plskeggs/nubotics-wheelwatcher/code/examples/oopic/oopic_bot.jpg

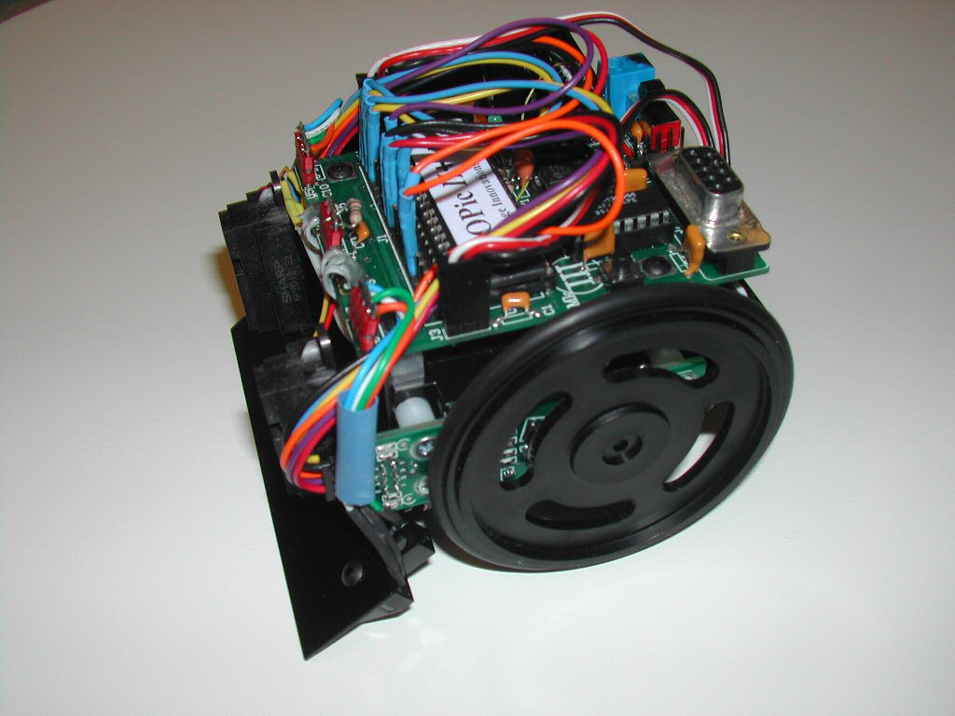
code/examples/oopic/oopic_bot.jpg
