plskeggs/nubotics-wheelwatcher/README.md

# nubotics-wheelwatcher
Welcome to the open hardware and firmware repository for the Nubotics WheelWatcher encoders, 
models WW-11 (for standard size servos) and WW-12 (for specific gearhead motors).

We started designing and manufacturing the original WheelWatcher encoders in 2004.
Much has changed in the hobby robotics field in the last 12 years.  We ceased
manufacturing both products, and closed our web store after selling the last
WheelWatchers, in late 2015.

Rather than letting these designs disappear into the ether, we are opening them up so that
others may carry the torch and either build them for themselves or manufacturer
and sell them to others.  We only ask that you read, understand, and respect
the licenses we have applied.

The hardware portions are licensed under The TAPR Open Hardware License
Version 1.0 (May 25, 2007).  See the file hardware/LICENSE.TXT or find it here:
http://www.tapr.org/OHL.

The firmware portions are licensed under the Gnu Public License (GPL) v3
(June 29, 2007).  See the file code/WW-1x-firmware/COPYING or find it here:
http://www.gnu.org/licenses/.

The example programs are provided as-is, public domain.

January 2016, Noetic Design, Inc.
