plskeggs/nubotics-wheelwatcher/hardware/AL-02/tooling-c.pdf

Date 2/8/2005 | Document Number | Sheet 1 1 002-0005-001
1.04 | | Of

# WheelWatcher Alignment Tool

## Noetic Design, Inc. 25 NW 23rd PL STE 6 PMB 181

## Portland, OR 97210

503-223-9239

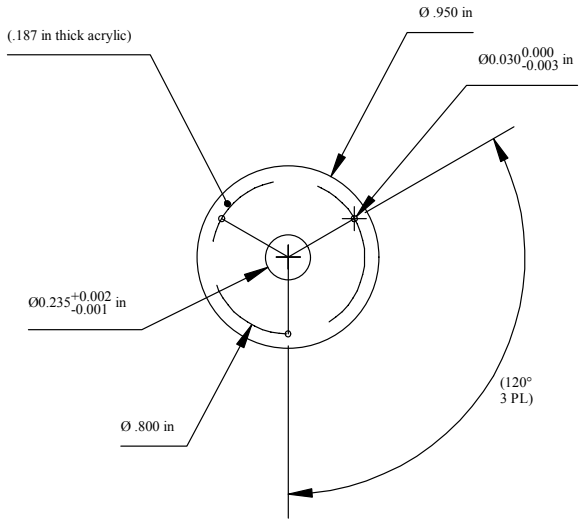
[picture p2: figure]
(.187 in thick acrylic)
