plskeggs/nubotics-wheelwatcher/hardware/WW-11/mechanical/detector-spacing.pdf

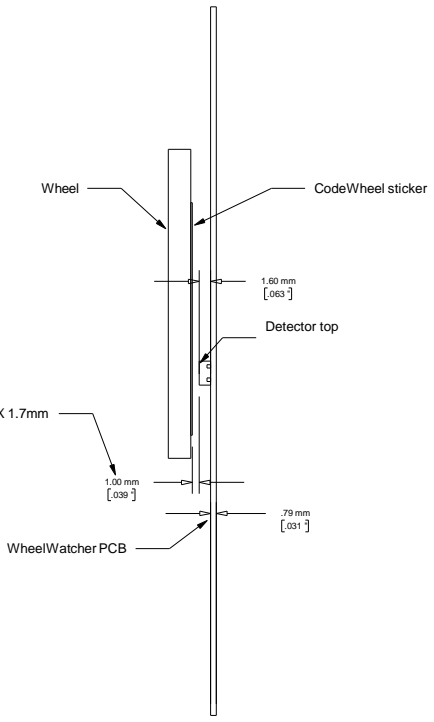
[picture p3: figure]
CodeWheel sticker; WheelWatcher PCB; Detector top; Wheel

Detector to CodeWheel spacing: MIN 0.3mm, MAX 1.7mm
