plskeggs/nubotics-wheelwatcher/hardware/WW-11/mechanical/detector-spacing.png

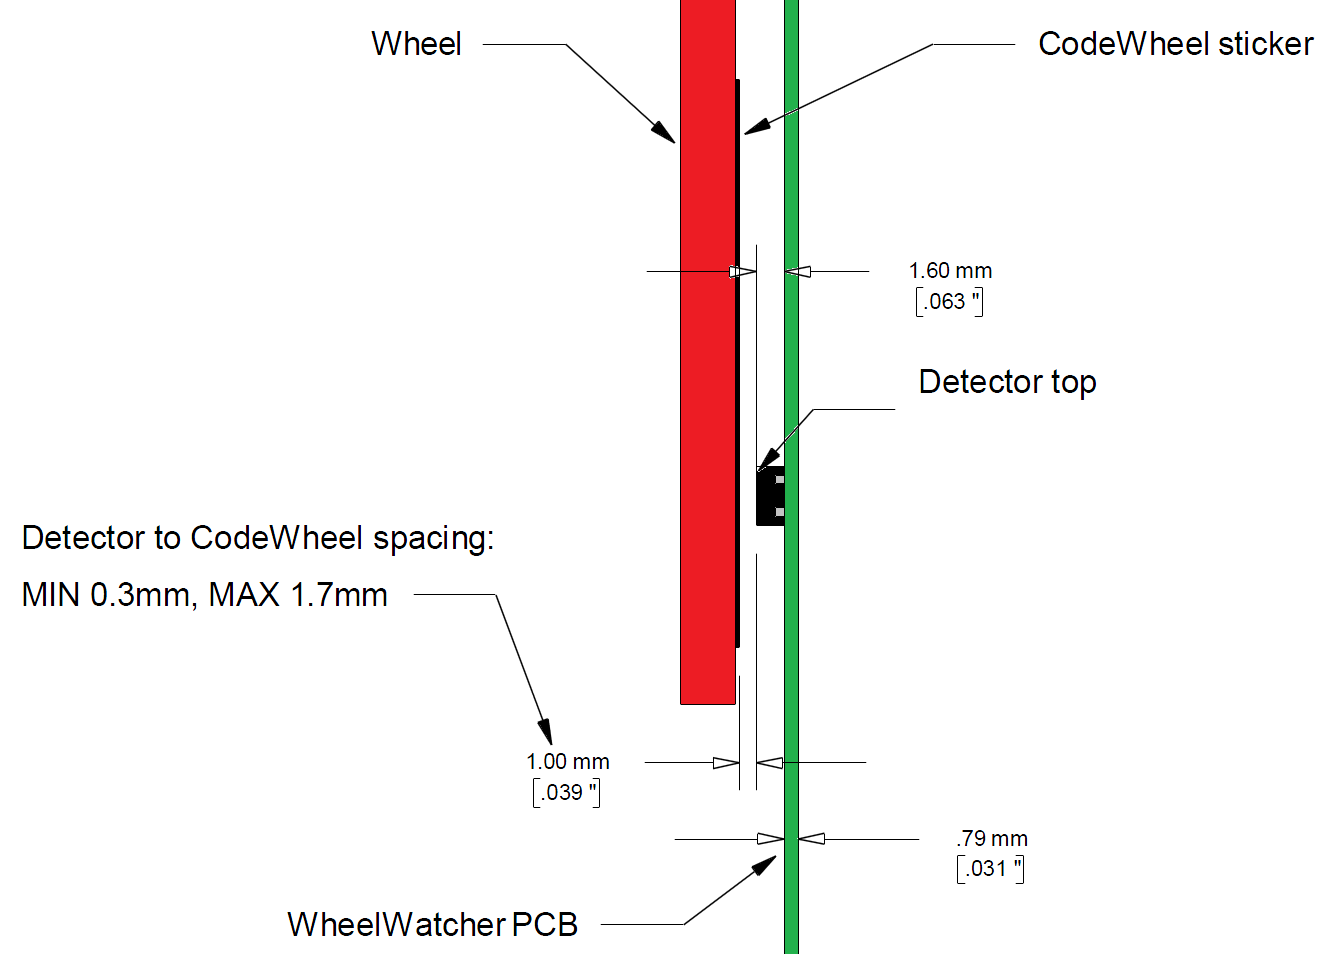
hardware/WW-11/mechanical/detector-spacing.png
