plskeggs/nubotics-wheelwatcher/hardware/WW-11/mechanical/fab.png

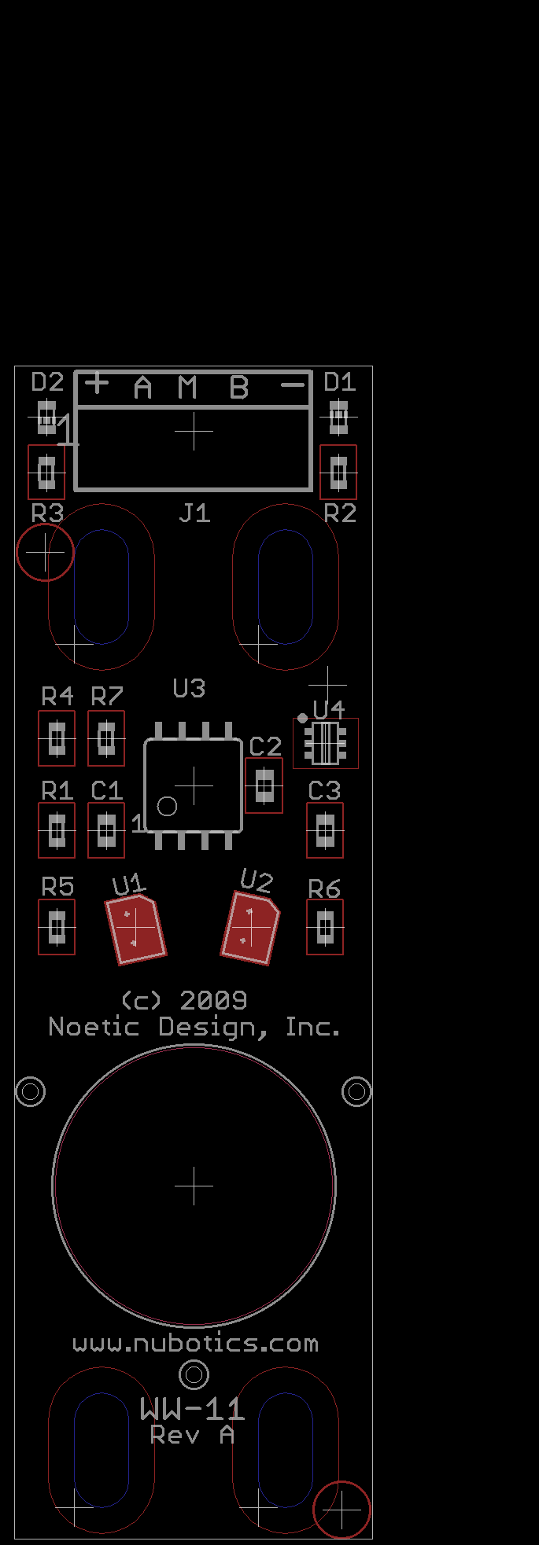
hardware/WW-11/mechanical/fab.png
