plskeggs/nubotics-wheelwatcher/hardware/WW-11/mechanical/WW-11-outline.png

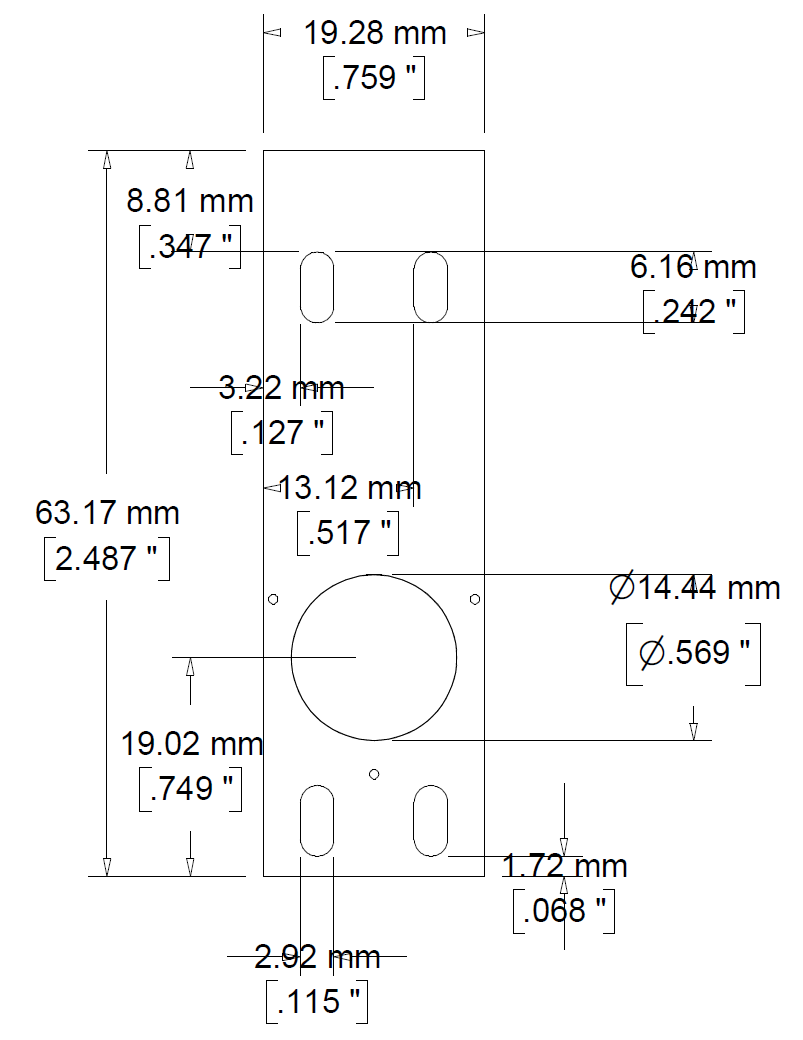
hardware/WW-11/mechanical/WW-11-outline.png
