plskeggs/nubotics-wheelwatcher/hardware/WW-12/mechanical/WW-12-outline.png

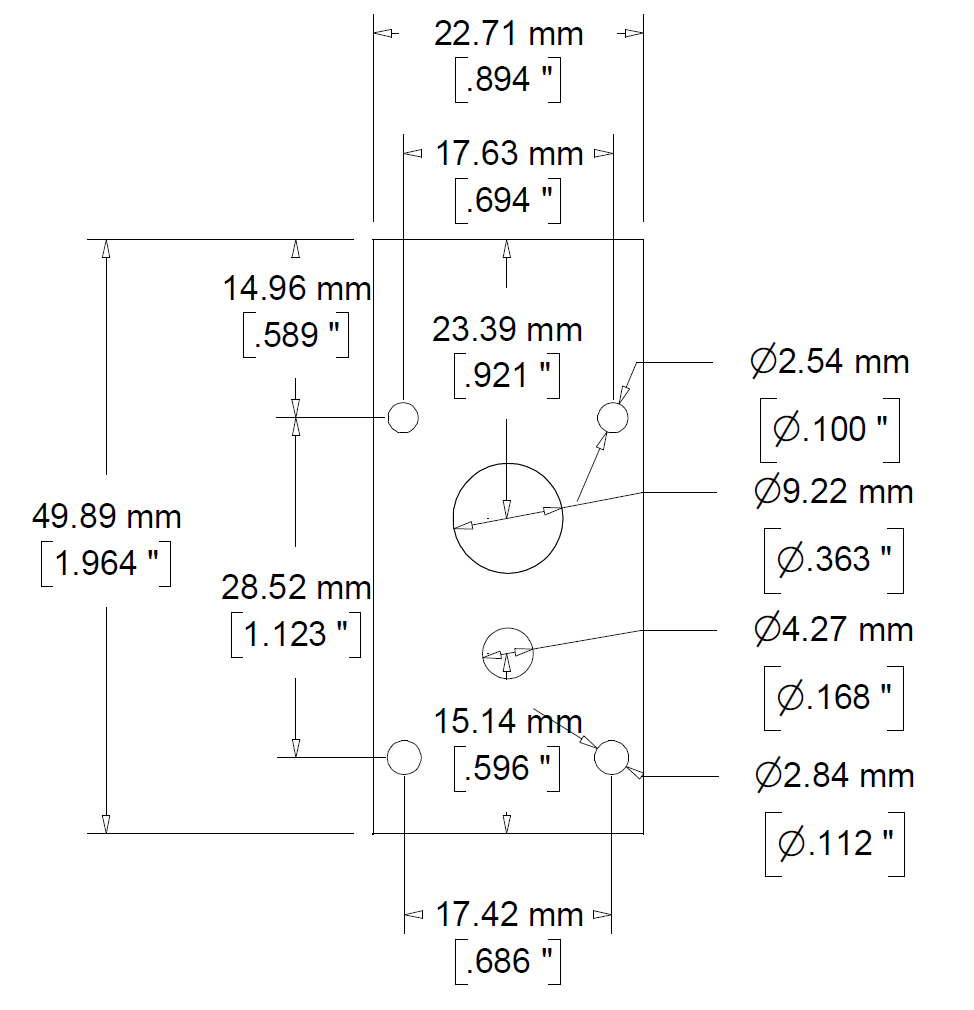
hardware/WW-12/mechanical/WW-12-outline.png
