plskeggs/nubotics-wheelwatcher/hardware/WW-11/WW-11-BOM.xls

 |  |  | Wheel Watcher Encoder WW-11
 |  |  | Rev A
 |  |  | Noetic Design, Inc.
 |  |  | 25 NW 23rd PL STE 6 PMB 181
 |  |  | Portland, Oregon 97210
 |  |  | 503-223-9239
 |  |  | Bill Of Materials |  |  |  |  |  |  |  |  |  |  | 500 | 1000
 |  |  |  |  |  |  |  |  |  |  |  |  | -1000 | Cost | Cost | delta
Item | Qty | Ord | Part Description | Case | Manufacturer | Part Number | Ref Designator | Mouser | Digikey | Price Each |  | Total
1 | 3 |  | Capacitor, Ceramic, 16V, X7R, 100 nF | 0603 |  |  | C1, C2, C3 |  |  | $0.01 | 3 | $0.01 | $0.01 | $7.50 | $15.00 | $7.50
2 | 1 |  | Diode, Light Emitting, Yellow, SMT | 0603 | Liteon | LTST-C190KYKT | D1 |  | 67-1551-1-ND | $0.06 | 1 | $0.06 | $0.06 | $27.50 | $55.00 | $27.50
3 | 1 |  | Diode, Light Emitting, Green, SMT | 0603 | Liteon | LTST-C190KGKT | D2 |  | 67-1693-1-ND | $0.06 | 1 | $0.06 | $0.06 | $27.50 | $55.00 | $27.50
4 | 1 |  | Resistor, Thick Film 0.1W, 50V, 1%, 100 ohm | 603 |  |  | R1 |  |  |  | 1
5 | 2 |  | Resistor, Thick Film, 0.1W, 50V, 1%, 475 ohm | 0603 |  |  | R2, R3 |  |  | $0.002 | 2 | $0.004 | $0.004 | $2.00 | $4.00 | $2.00
6 | 1 |  | Resistor, Thick Film, 0.1W, 50V, 1%, 1.0 M | 0603 |  |  | R4 |  |  | $0.002 | 1 | $0.002 | $0.002 | $1.00 | $2.00 | $1.00
7 | 2 |  | Resistor, Thick Film, 0.1W, 50V, 1%, 40.0K | 0603 |  |  | R5, R6 |  |  | $0.002 | 2 | $0.004 | $0.004 | $2.00 | $4.00 | $2.00
8 | 0 |  | Resistor, Thick Film, 0.1W, 50V, 1%, 0 ohm | 0603 |  |  | R7 |  |  | $0.002 | 0 | $0.00 | $0.00 | $0.00 | $0.00 | $0.00
9 | 2 |  | Photomicrosensor, SMT | 4TSOP | Fairchild | QRE1113GR | U1, U2 |  |  | $0.48 | 2 | $0.96 | $0.96 | $480.00 | $960.00 |  | tape/reel? Get quote for 2000-3000
10 | 1 |  | Atmel ATTINY85 Microcontroller, 8K Flash | SOIC8 | Atmel | ATtiny85-15ST | U3 |  |  |  | 1
11 | 1 |  | Dual Schmidt Trigger Inverter, SMT | SC70-6 | Fairchild | NC7WZ14P6X | U4 | 512-NC7WZ14P6X |  | $0.09 | 1 | $0.09 | $0.09 | $45.00 | $810.00 | $765.00 | $0.77 | 750% | 3000 units in tape and reel for 0.27 each = | 810
 |  |  | PCB component total |  |  |  |  |  |  |  |  | $1.19 | $1.19
15 | 1 |  | PCB fab |  |  |  |  | (2 week, Advanced Circuits) |  | $2.86 |  | $2.86 | $0.00 | $1430.00 | $0.00
16 | 1 |  | PCB assy |  |  |  |  | (CBRAM) |  | $2.50 |  | $2.50 | $2.00 | $1250.00 | $2000.00
 |  |  | assembled PCB total |  |  |  |  |  |  |  |  | $6.54 | $3.19
17 | 1 |  | encoder disk |  |  |  |  | (Gillespie, I-Cut) |  | $0.94 |  | $0.94 | $0.66 | $470.00 | $660.00 | $190.00
18 | 0 |  | alignment tool |  |  |  |  | (Filener laser cut + 3 .031" pins) |  | $0.77 |  | $0.00 | $0.00 | $0.00 | $0.00
19 | 1 |  | hardware (screws, standoffs) |  |  |  |  |  |  | $0.68 |  | $0.68 | $0.68 | $340.00 | $680.00
 |  |  | total |  |  |  |  |  |  |  |  | $8.16 | $4.53
 | 1 |  | alt- PKC connector |  |  |  |  |  |  |  |  | $1.15 | $1.08
20 | 1 |  | right angle header | 1 | Hirose | DF11-8DP-2DS(22) | J1 |  | H2063-ND | $0.20 |  | $0.20 | $0.20
20 | 0 |  | connector housing | 1 | Hirose | DF11-8DS-2C |  |  | H2022-ND | $0.07 |  | $0.00 | $0.00 | $0.00 | $0.00 | $0.00
21 | 0 | Ö | wires, 6 different colors | 6 | Digikey | H3BXT-10106-B6-ND |  |  | H3BXT-10106-B6-ND | $0.32 |  | $0.00 | $0.00 | $0.00 | $0.00 | $0.00
 |  |  | complete kit |  |  |  |  |  |  |  |  | $9.51 | $5.81
 |  |  |  |  |  |  |  |  |  |  |  | $8.16 | $5.25 | $4082.50 | $5245.00 | $1022.50
 |  |  |  | MSRP | 500 | 1000
 |  |  | with Digikey cabling |  | 29.39 | 23.2
 |  |  | with PKC cabling |  | 26.8 | 21.29
 |  |  | reduction (order 1000, use PKC): |  |  | 0.2756039469
