plskeggs/nubotics-wheelwatcher/hardware/WW-12/WW-12-BOM.xls

Sheet: bom
WW-12 Rev A BOM
Part | Quantity | Part Number | Value | Package | Delivered to SMTNW | 2012-11-01
C1-C3 | 3 | 11-0165 | 0.1uF | C0603 | 2500
D1 | 1 | 04-0232 | LTST-C190KYKT yellow | CHIP-LED0603 | 3000
D2 | 1 | 04-0128 | LTST-C190KGKT green | CHIP-LED0603 | 3000
J1 | 1 | 13-0262 | 22-23-2051 | 22-23-2051 | 420 | NOTE: these are the hand-adds, and we're short. Please just do the 420 and we'll do the last 100 when they come in.
R1 | 1 | 10-0131 | 100 | R0603 | 3500
R2-R3 | 2 | 10-0124 | 470 | R0603 | 4000
R4 | 1 | 10-0263 | 1M | R0603 | 4000
R5-R6 | 2 | 10-0264 | 40K | R0603 | 3000
R7 | 1 | 10-0194 | 0 | R0603 | 4000
U1-U2 | 2 | 03-0261 | QRE1113GR | 4TSOP | 1052 | NOTE: this is barely enough. If you run out, omit from the rest of the run.
U3 | 1 | 00-0260 | Atmel ATTINY85 | SOIC8 | 535
U4 | 1 | 02-0127 | NC7WZ14P6X | SOT65P210X110-6AN_SC88_SC70-6 | 1500
PCB | 1 | 17-0273 | 2 sided 0.031" FR4 |  | 0 | NOTE: due to arrive Monday 11/5/2012 from Advanced Circuits.

Sheet: parts
WW-12 Rev A BOM
Part | Part Number | Value | Package | Position (inch) | Orientation | Quantity
C1 | 11-0165 | 0.1uF | C0603 | (0.205 1.465) | R270 | 4000
C2 | 11-0165 | 0.1uF | C0603 | (0.645 0.8) | R270
C3 | 11-0165 | 0.1uF | C0603 | (0.555 1.465) | R270
D1 | 04-0232 | LTST-C190KYKT yellow | CHIP-LED0603 | (0.72 1.96) | R90 | ~1000
D2 | 04-0128 | LTST-C190KGKT green | CHIP-LED0603 | (0.04 1.96) | R270 | ~1000
J1 | 13-0262 | 22-23-2051 | 22-23-2051 | (0.38 1.845) | R0 | 0 (backordered)
R1 | 10-0131 | 100 | R0603 | (0.115 0.8) | R90 | ~4000
R2 | 10-0124 | 470 | R0603 | (0.72 1.845) | R180 | 5000
R3 | 10-0124 | 470 | R0603 | (0.04 1.845) | R0
R4 | 10-0263 | 1M | R0603 | (0.205 1.605) | R270 | ~4500
R5 | 10-0264 | 40K | R0603 | (0.545 0.8) | R90 | ~4000
R6 | 10-0264 | 40K | R0603 | (0.215 0.8) | R90
R7 | 10-0194 | 0 | R0603 | (0.555 1.605) | R90 | ~4500
U1 | 03-0261 | QRE1113GR | 4TSOP | (0.582 0.608) | R21.1 | 1025
U2 | 03-0261 | QRE1113GR | 4TSOP | (0.178 0.608) | R338.9
U3 | 00-0260 | Atmel ATTINY85 | SOIC8 | (0.38 1.535) | R0 | 510
U4 | 02-0127 | NC7WZ14P6X | SOT65P210X110-6AN_SC88_SC70-6 | (0.715 1.635) | R0 | ~2000
PCB | 17-0273 | 2 sided 0.031" FR4
