plskeggs/nubotics-wheelwatcher/hardware/WW-11/mechanical/WW-11.dxf

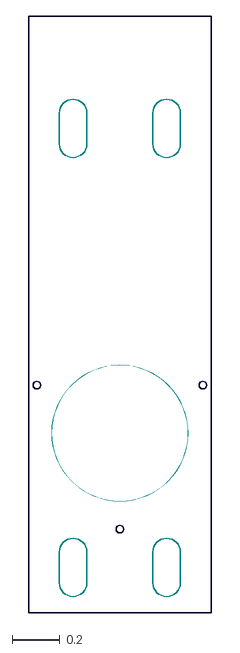
[picture p8: CAD file, 2016-01-25]
hardware/WW-11/mechanical/WW-11.dxf
0.759 x 2.49
