plskeggs/nubotics-wheelwatcher/hardware/WW-12/mechanical/WW-12.dxf

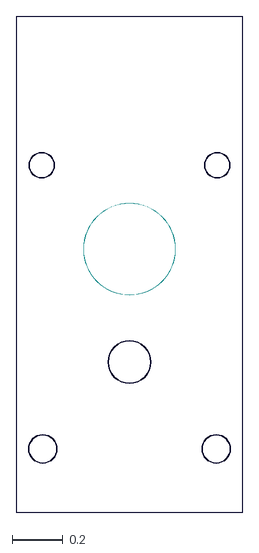
[picture p9: CAD file, 2016-01-25]
hardware/WW-12/mechanical/WW-12.dxf
0.895 x 1.97
