plskeggs/nubotics-wheelwatcher/(list of files, cad)

Other CAD files:
hardware/WW-11/test fixture/test-fixture2.dwg
