plskeggs/nubotics-wheelwatcher/hardware/WW-11/WW-11-layout.pdf

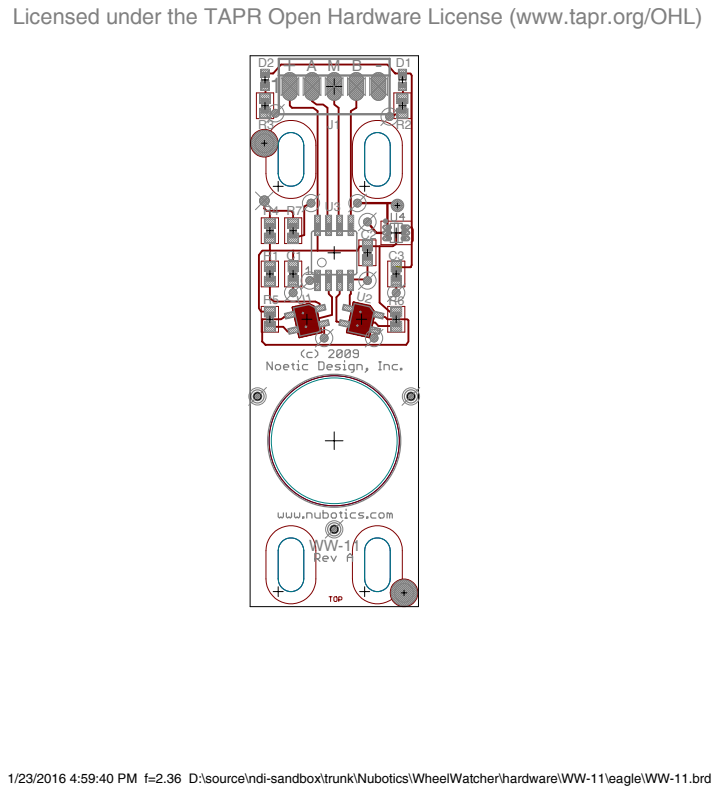
[picture p23: page 1]

Licensed under the TAPR Open Hardware License (www.tapr.org/OHL)

1/23/2016 4:59:40 PM f=2.36 D:\source\ndi-sandbox\trunk\Nubotics\WheelWatcher\hardware\WW-11\eagle\WW-11.brd
