plskeggs/nubotics-wheelwatcher/hardware/WW-11/WW-11-schematic.pdf

A

A

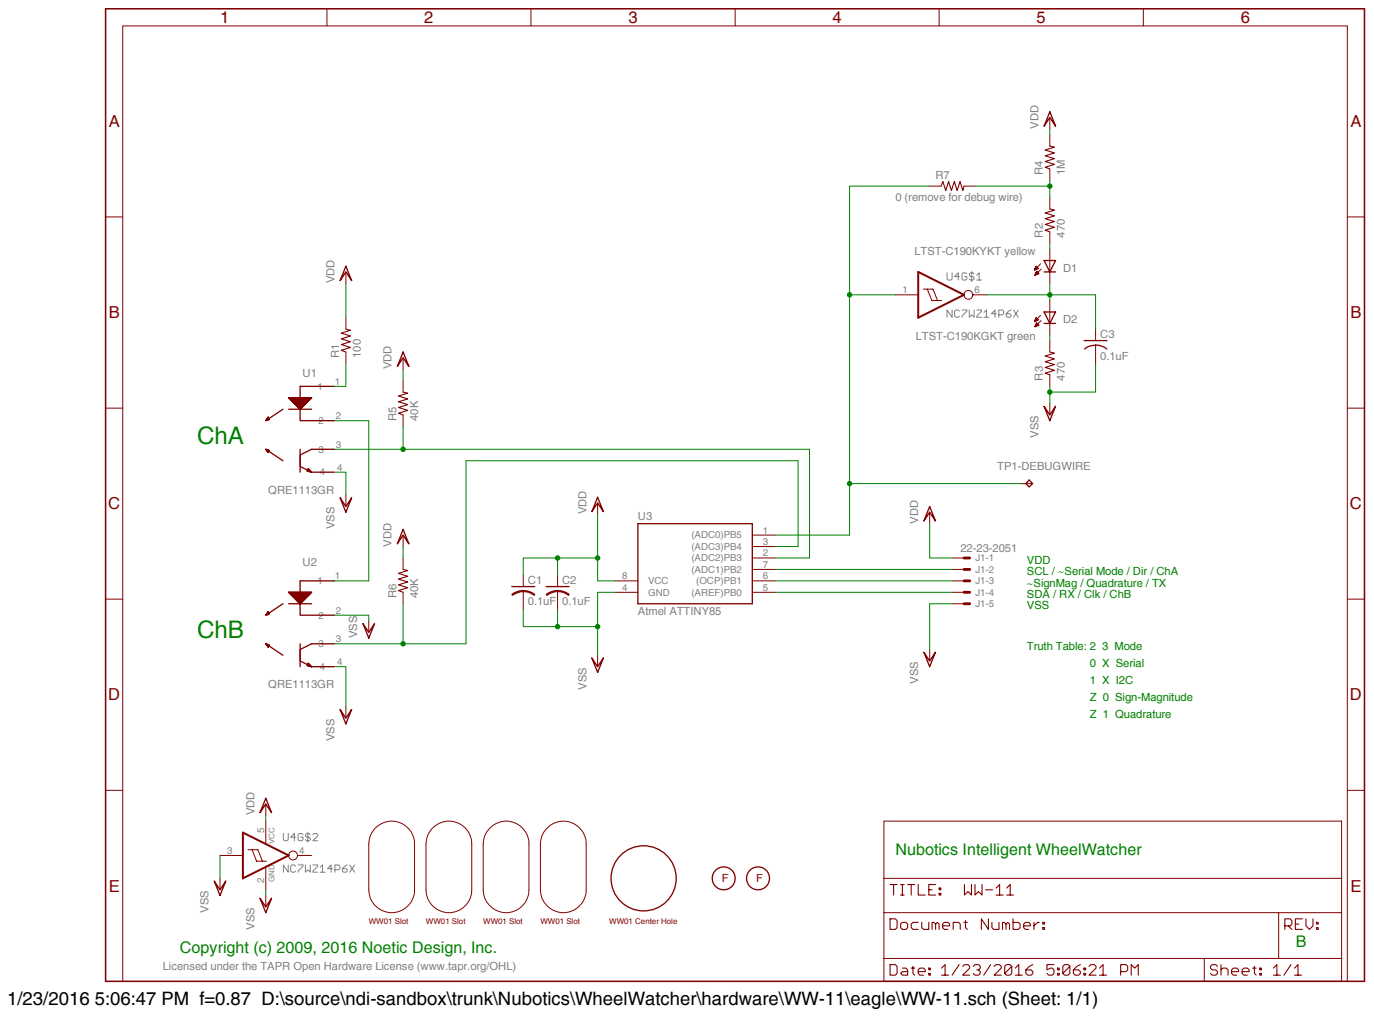
[picture p24: page 1]

0 (remove for debug wire)

VDD
SCL / ~Serial Mode / Dir / ChA
~SignMag / Quadrature / TX
SDA / RX / Clk / ChB
VSS

Copyright (c) 2009, 2016 Noetic Design, Inc.
Licensed under the TAPR Open Hardware License (www.tapr.org/OHL)

1/23/2016 5:06:47 PM f=0.87 D:\source\ndi-sandbox\trunk\Nubotics\WheelWatcher\hardware\WW-11\eagle\WW-11.sch (Sheet: 1/1)
