plskeggs/nubotics-wheelwatcher/hardware/WW-12/WW-12-layout.pdf

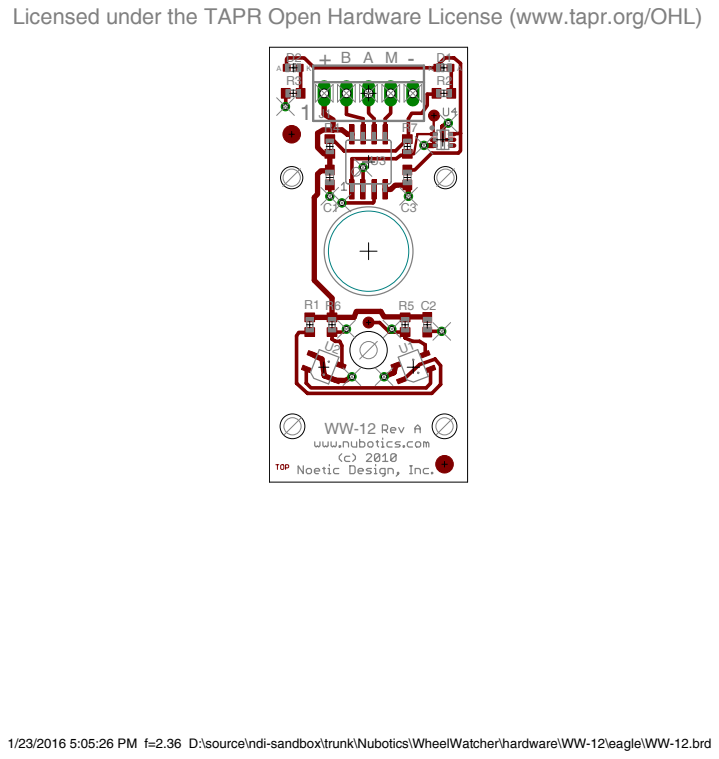
[picture p25: page 1]

Licensed under the TAPR Open Hardware License (www.tapr.org/OHL)

1/23/2016 5:05:26 PM f=2.36 D:\source\ndi-sandbox\trunk\Nubotics\WheelWatcher\hardware\WW-12\eagle\WW-12.brd
