plskeggs/nubotics-wheelwatcher/hardware/WW-12/WW-12-schematic.pdf

A

A

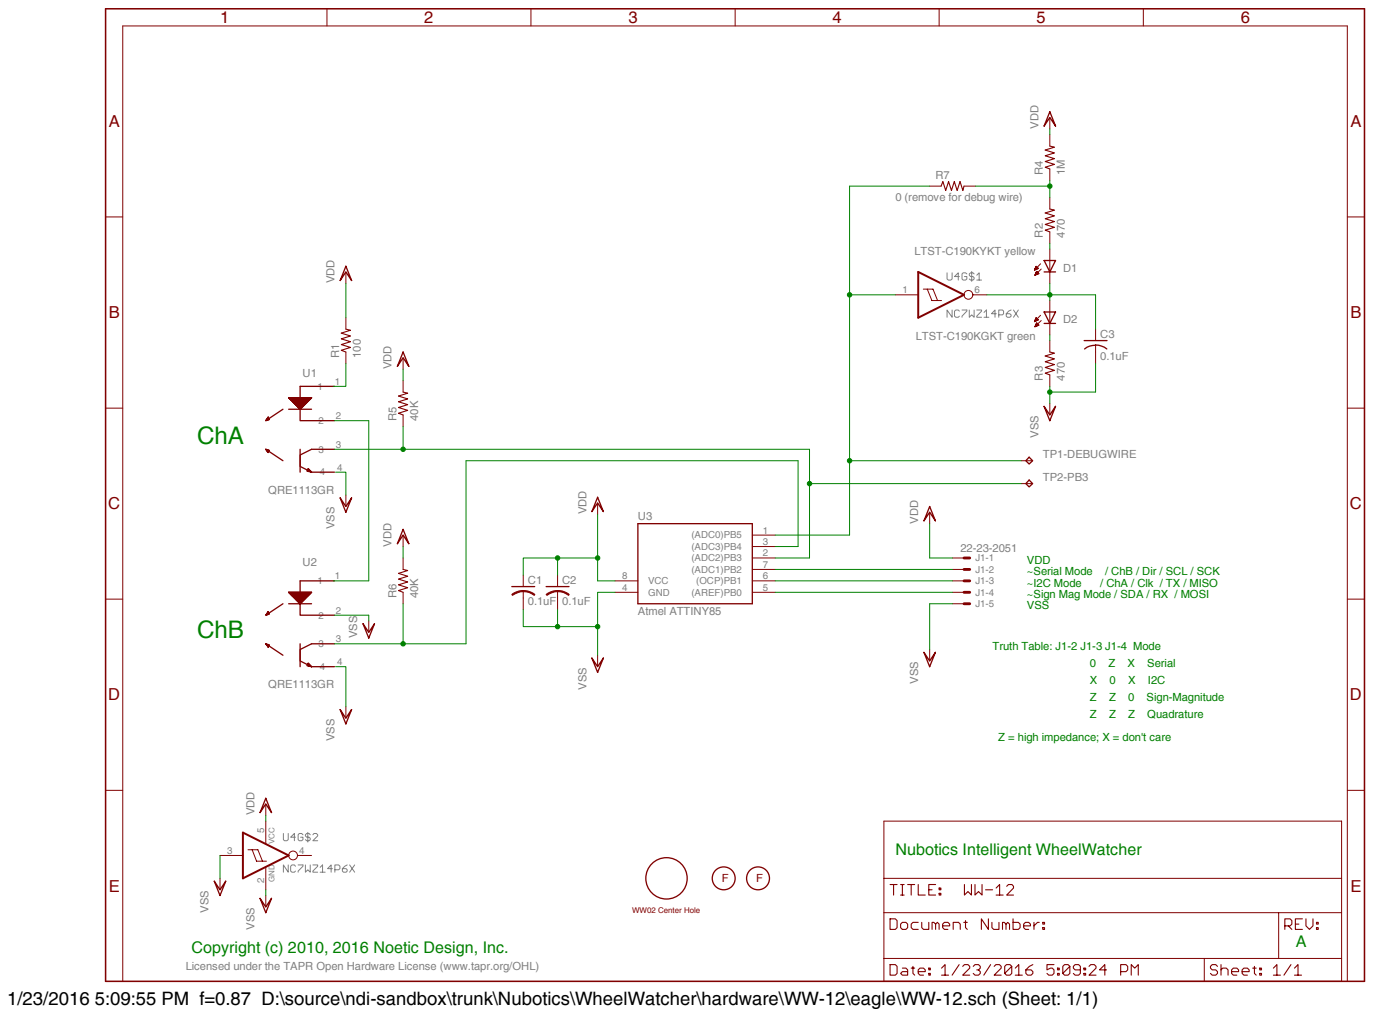
[picture p26: page 1]

0 (remove for debug wire)

VDD
~Serial Mode / ChB / Dir / SCL / SCK
~Sign Mag Mode / SDA / RX / MOSI
VSS

Z = high impedance; X = don't care

Copyright (c) 2010, 2016 Noetic Design, Inc.
Licensed under the TAPR Open Hardware License (www.tapr.org/OHL)

1/23/2016 5:09:55 PM f=0.87 D:\source\ndi-sandbox\trunk\Nubotics\WheelWatcher\hardware\WW-12\eagle\WW-12.sch (Sheet: 1/1)
