plskeggs/nubotics-wheelwatcher/hardware/WW-11/mechanical/ww-11-fab.pdf

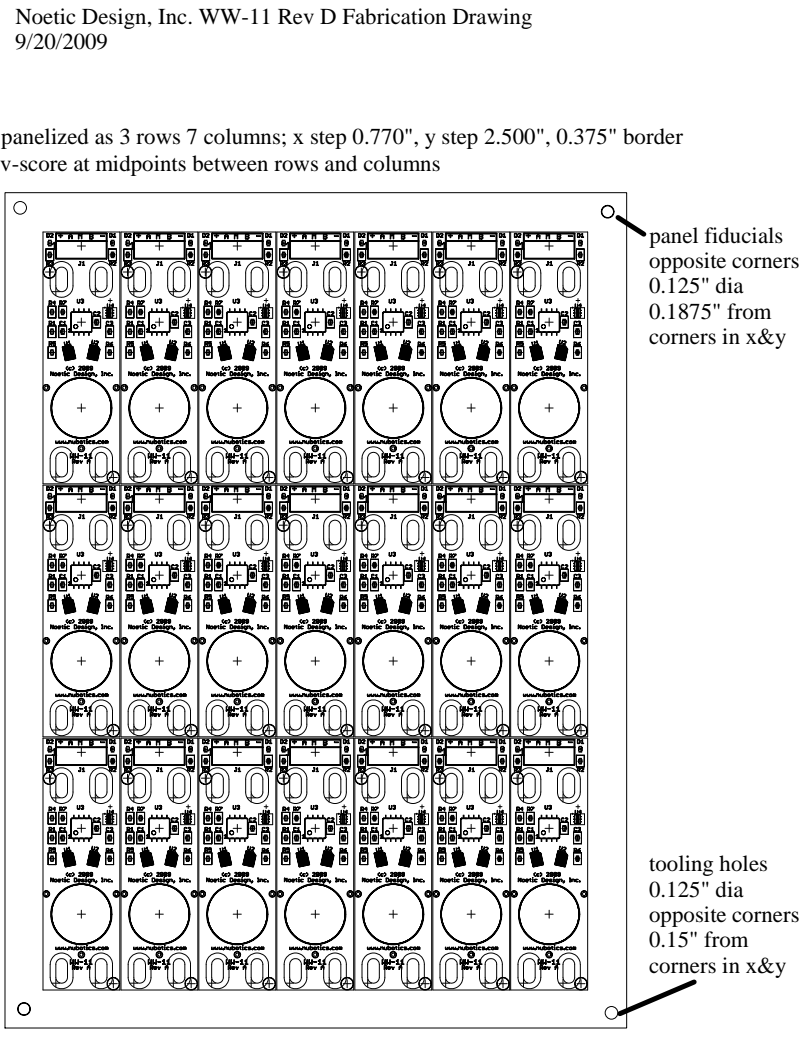
[picture p27: page 1]
panel fiducials opposite corners 0.125" dia 0.1875" from corners in x&y; tooling holes 0.125" dia opposite corners 0.15" from corners in x&y

Noetic Design, Inc. WW-11 Rev D Fabrication Drawing

panelized as 3 rows 7 columns; x step 0.770", y step 2.500", 0.375" border
v-score at midpoints between rows and columns
