plskeggs/nubotics-wheelwatcher/hardware/WW-12/programming fixture/WW-12-fixture-layout.pdf

## Licensed under the TAPR Open Hardware License (www.tapr.org/OHL)

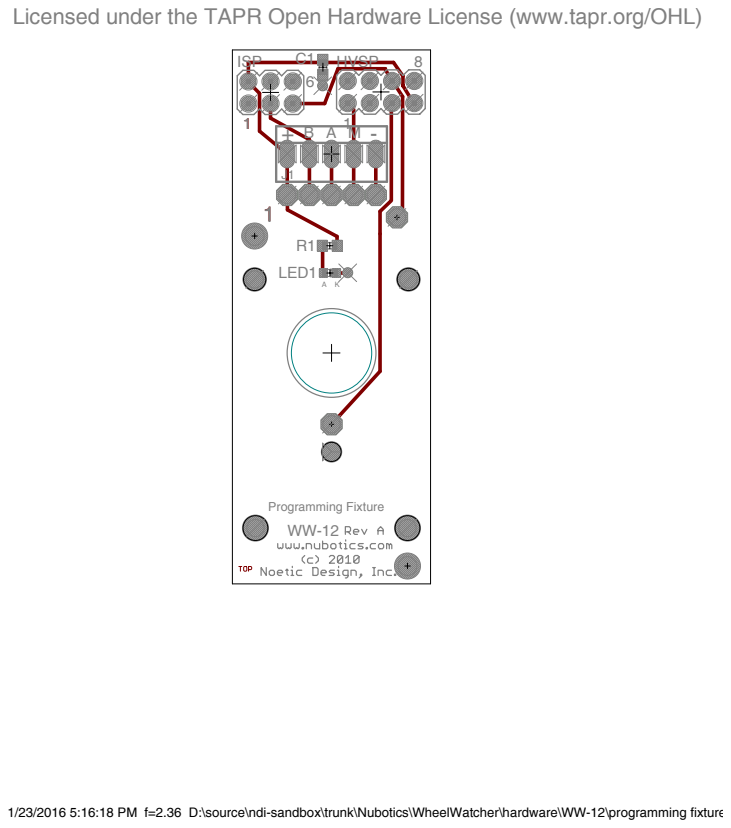
[picture p28: page 1]
Programming Fixture; ISP; HVSP; LED1

1/23/2016 5:16:18 PM f=2.36 D:\source\ndi-sandbox\trunk\Nubotics\WheelWatcher\hardware\WW-12\programming fixture\WW-12-fixture.brd
