plskeggs/nubotics-wheelwatcher/hardware/WW-12/programming fixture/WW-12-fixture-schematic.pdf

A

A

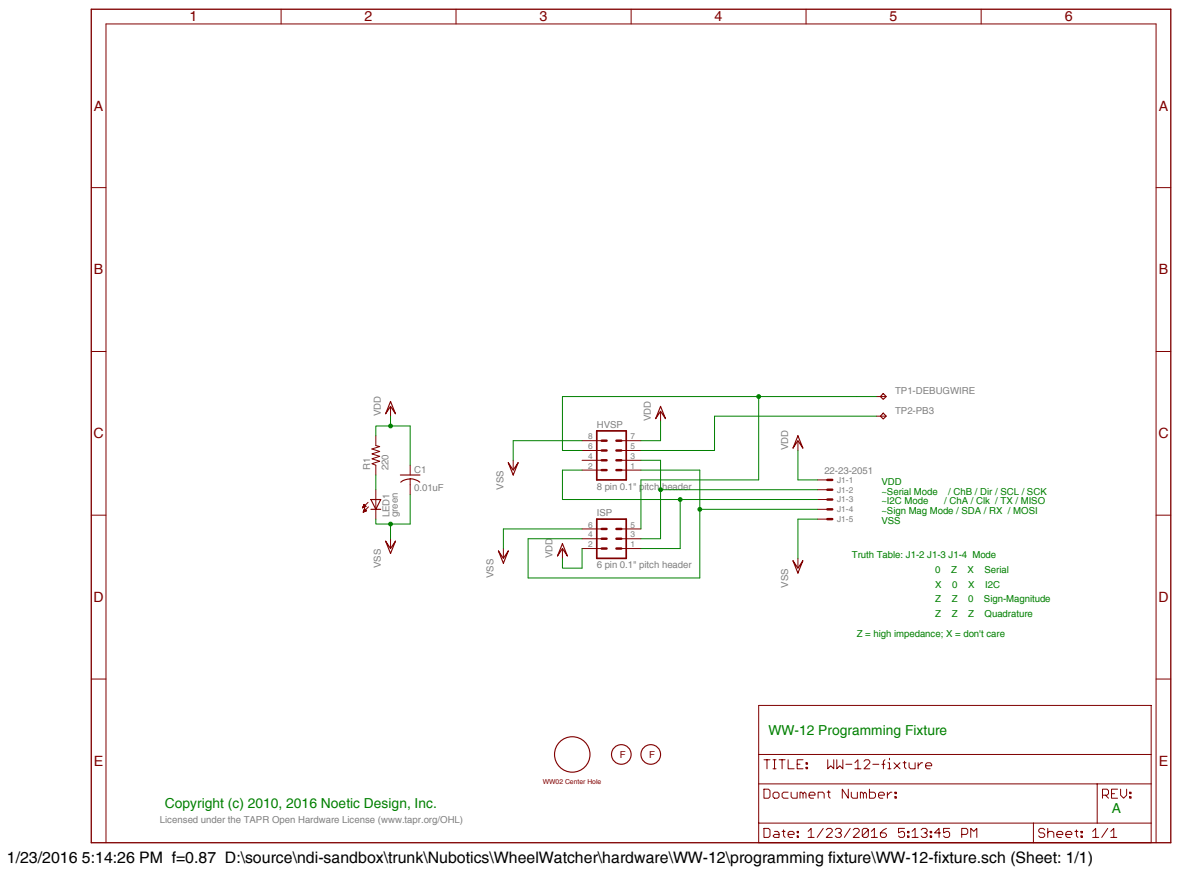
[picture p29: page 1]
VSS VDD; 6 pin 0.1" pitch header; 8 pin 0.1" pitch header; VSS; VDD; green; TP1-DEBUGWIRE; ISP; HVSP; LED1; WW02 Center Hole; ~I2C Mode; / ChA / Clk / TX / MISO; 0 Z X Serial X 0 X I2C Z Z 0 Sign-Magnitude Z Z Z Quadrature

VDD
~Serial Mode / ChB / Dir / SCL / SCK
~Sign Mag Mode / SDA / RX / MOSI
VSS

Truth Table: J1-2 J1-3 J1-4 Mode

Z = high impedance; X = don't care

WW-12 Programming Fixture

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

1/23/2016 5:14:26 PM f=0.87 D:\source\ndi-sandbox\trunk\Nubotics\WheelWatcher\hardware\WW-12\programming fixture\WW-12-fixture.sch (Sheet: 1/1)
