plskeggs/nubotics-wheelwatcher/hardware/AL-02/tooling-assy-fixture2.pdf

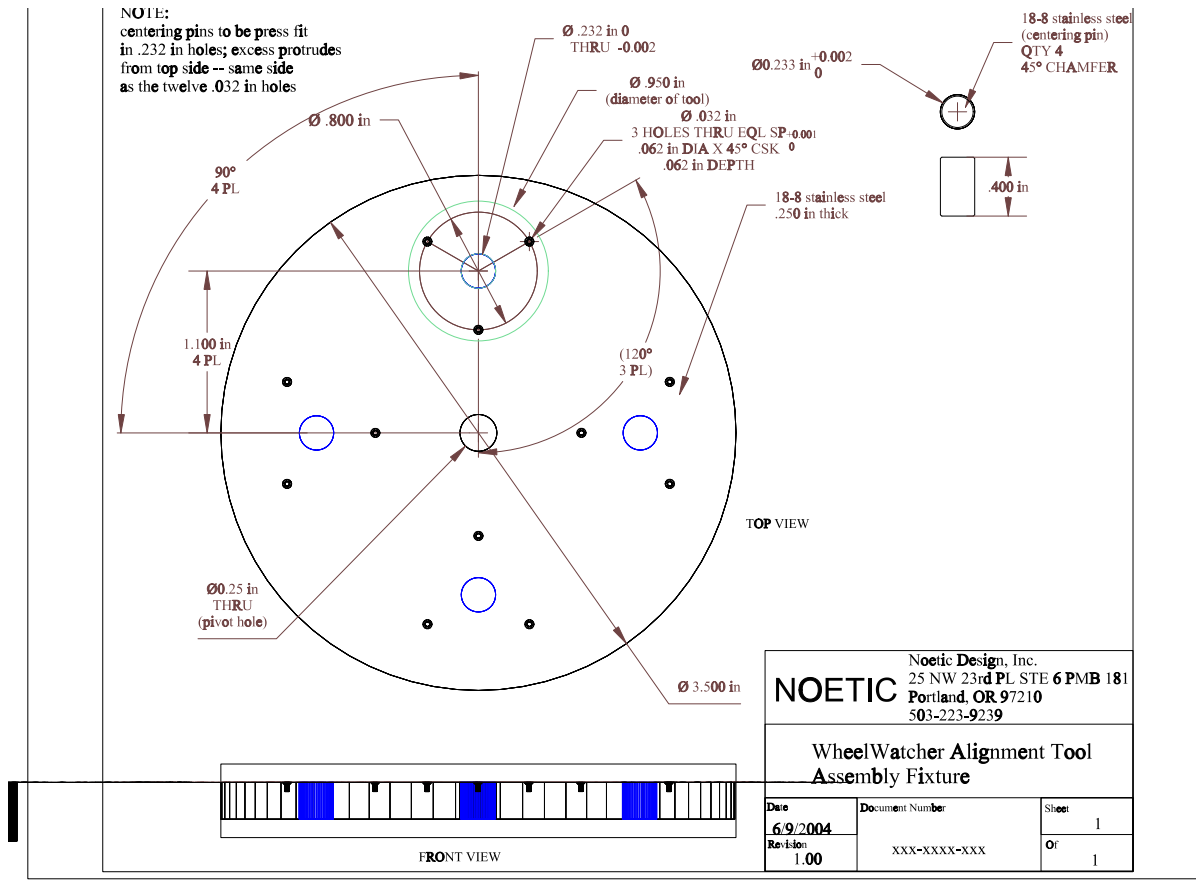
[picture p30: page 1]
