plskeggs/nubotics-wheelwatcher/hardware/CW-32/encoder-sticker-2.pdf

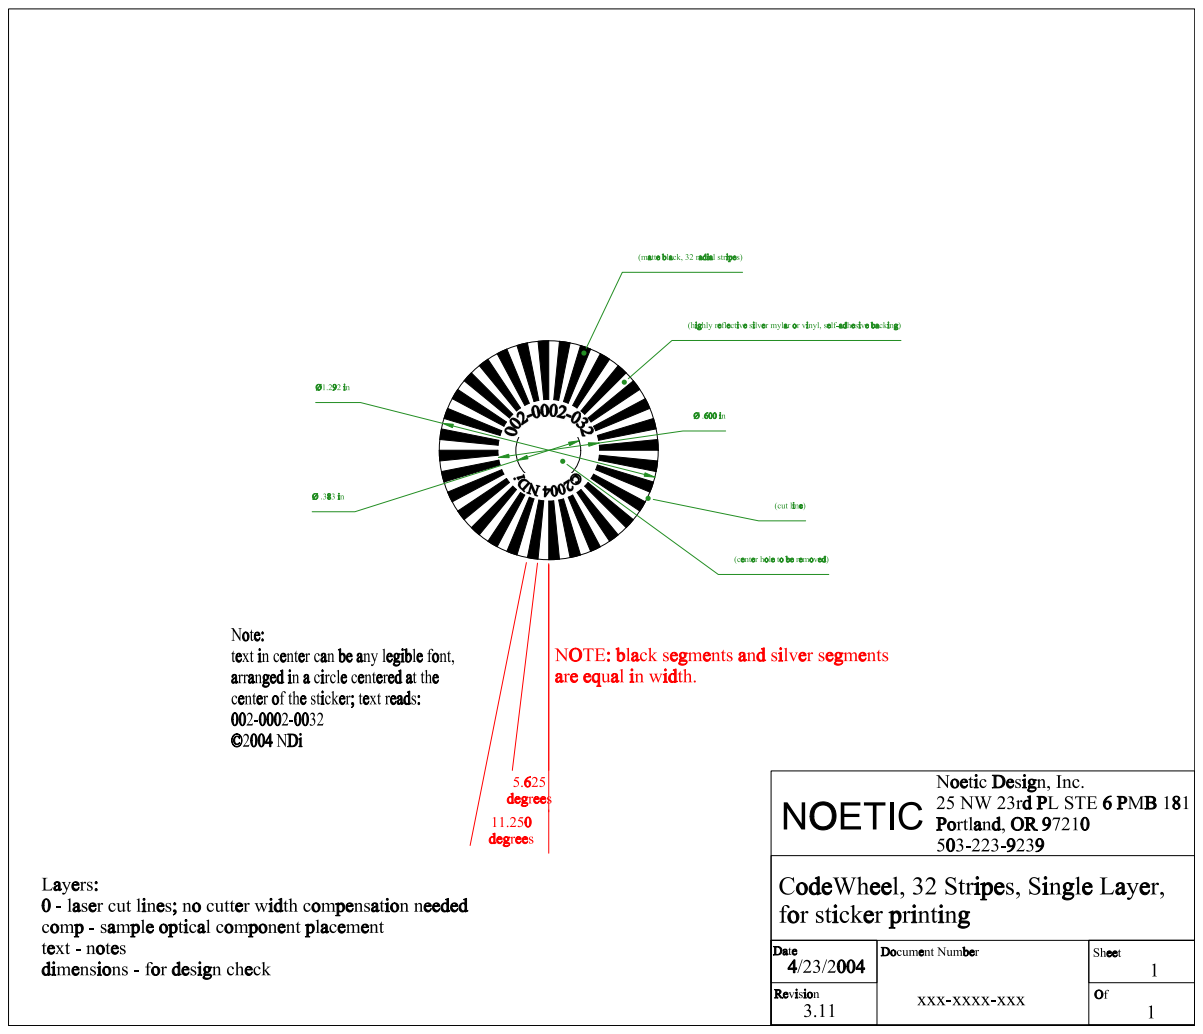
[picture p31: page 1]
