plskeggs/nubotics-wheelwatcher/hardware/WW-11/mechanical/WW-11-outline.pdf

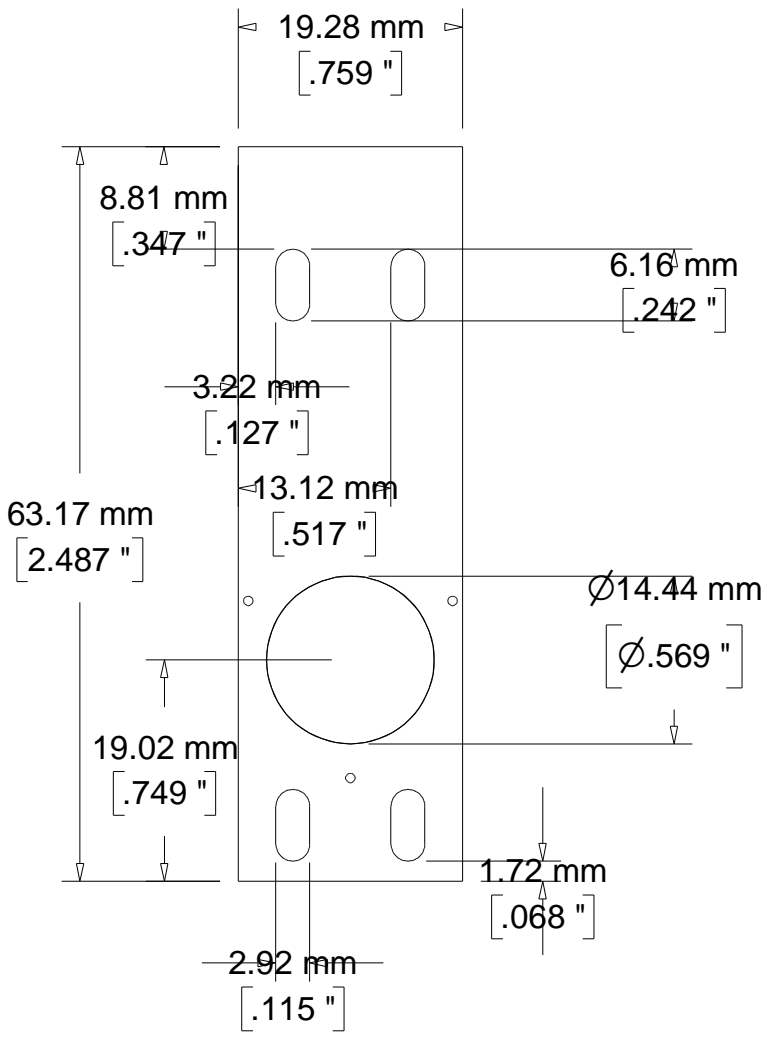
[picture p32: page 1]
