plskeggs/nubotics-wheelwatcher/hardware/WW-12/mechanical/WW-12-outline.pdf

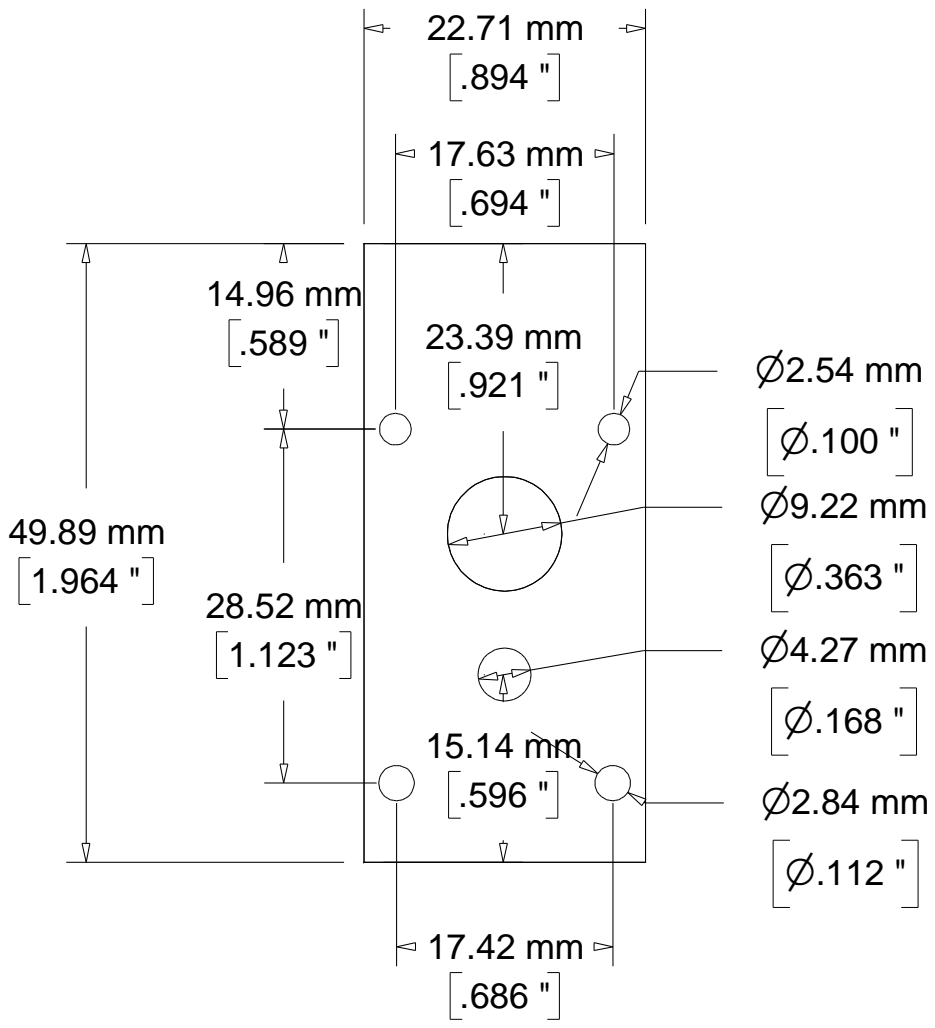
[picture p33: page 1]
