plskeggs/nubotics-wheelwatcher/hardware/WW-12/mechanical/WW12-assembly.pdf

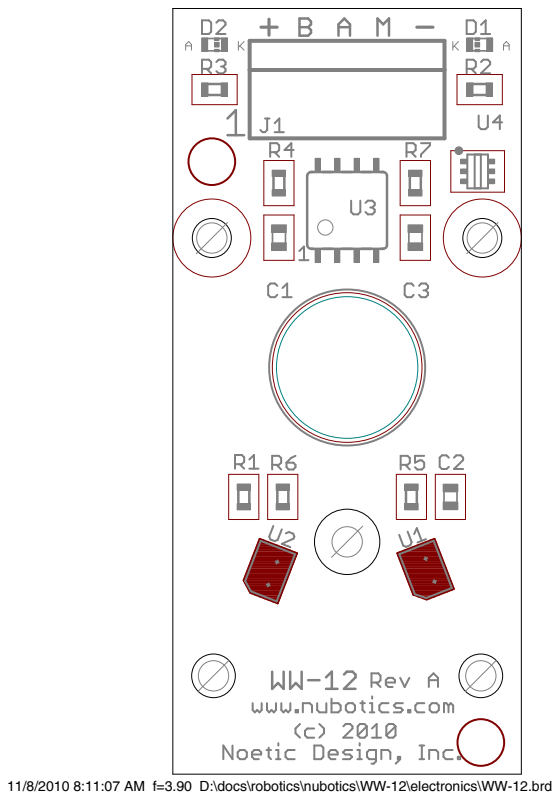
[picture p34: page 1]
