plskeggs/nubotics-wheelwatcher/hardware/WW-12/eagle/WW-12.brd

## EAGLE design hardware/WW-12/eagle/WW-12.brd (2016-01-25)

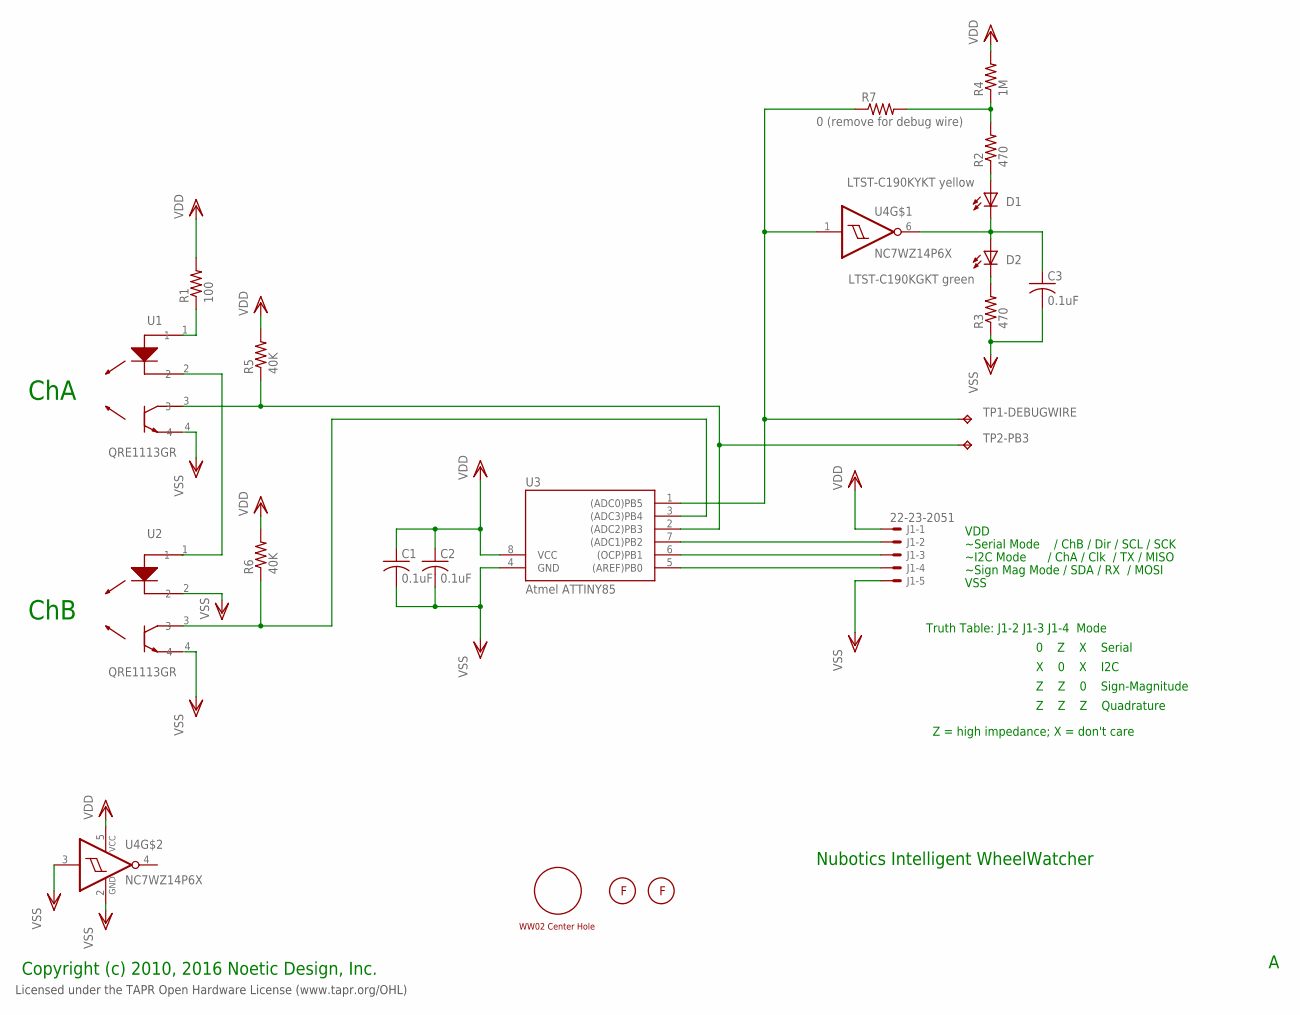
[picture p35: schematic WW-12.sch]

Parts:
C1, C2, C3: 0.1uF; C0603
D1: LTST-C190KYKT yellow; CHIP-LED0603
D2: LTST-C190KGKT green; CHIP-LED0603
FM1, FM2: FIDUCIAL2MMCIRCLE; FIDUCIAL_2MMCIRCLE
J1: 22-23-2051
R1: 100; R0603
R2, R3: 470; R0603
R4: 1M; R0603
R5, R6: 40K; R0603
R7: 0 (remove for debug wire); R0603
TP1-DEBUGWIRE, TP2-PB3: DEBUG WIRE; B1,27
U1, U2: QRE1113GR; 4TSOP
U3: Atmel ATTINY85; SOIC8
U4: NC7WZ14P6X; SOT65P210X110-6AN_SC88_SC70-6
U$1: WW02-CENTER

Connections:
unnamed: U1.2, U2.1
unnamed: R1.1, U1.1
unnamed: R5.1, TP2-PB3.TP, U1.3, U3.2 ((ADC2)PB3)
unnamed: R6.1, U2.3, U3.3 ((ADC3)PB4)
unnamed: D1.A, R2.1
unnamed: C3.1, D1.C, D2.A, U4.6 (O)
unnamed: D2.C, R3.2
unnamed: R2.2, R4.1, R7.2
unnamed: J1.2, U3.7 ((ADC1)PB2)
unnamed: R7.1, TP1-DEBUGWIRE.TP, U3.1 ((ADC0)PB5), U4.1 (I)
unnamed: J1.3, U3.6 ((OCP)PB1)
unnamed: J1.4, U3.5 ((AREF)PB0)
VDD: C1.1, C2.1, J1.1, R1.2, R4.2, R5.2, R6.2, U3.8 (VCC), U4.5 (VCC)
VSS: C1.2, C2.2, C3.2, J1.5, R3.1, U1.4, U2.2, U2.4, U3.4 (GND), U4.2 (GND), U4.3 (I)

Notes on the sheet:
~Serial Mode / ChB / Dir / SCL / SCK
~I2C Mode / ChA / Clk / TX / MISO
~Sign Mag Mode / SDA / RX / MOSI
VDD
VSS
Truth Table: J1-2 J1-3 J1-4 Mode
0 Z X Serial
X 0 X I2C
Z Z 0 Sign-Magnitude
Z Z Z Quadrature
Nubotics Intelligent WheelWatcher
Copyright (c) 2010, 2016 Noetic Design, Inc.
ChA
ChB
Z = high impedance; X = don't care
Licensed under the TAPR Open Hardware License (www.tapr.org/OHL)

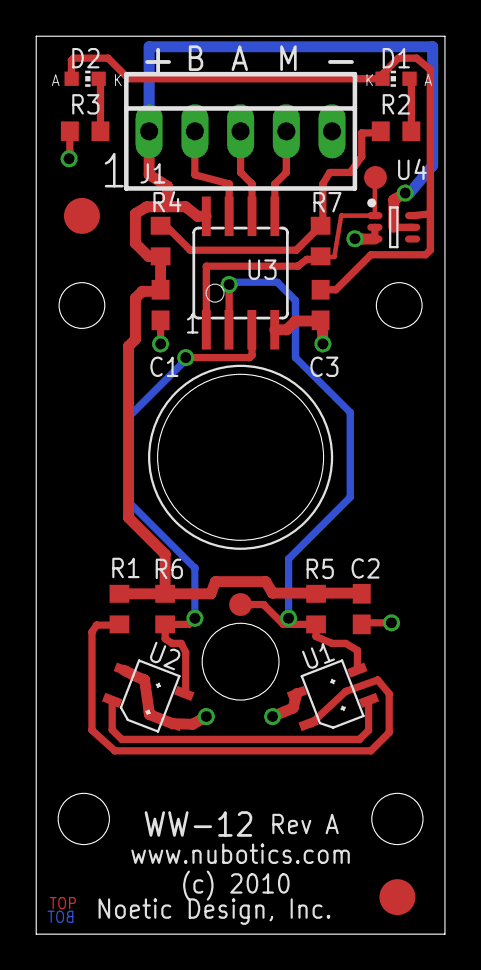
[picture p36: board WW-12.brd from above]

Board: 2 copper layers, 22.7 x 49.9 mm, 22 parts (0 on the bottom side), 14 nets.
