plskeggs/nubotics-wheelwatcher/hardware/WW-12/programming fixture/eagle/WW-12-fixture.brd

## EAGLE design hardware/WW-12/programming fixture/eagle/WW-12-fixture.brd (2016-01-25)

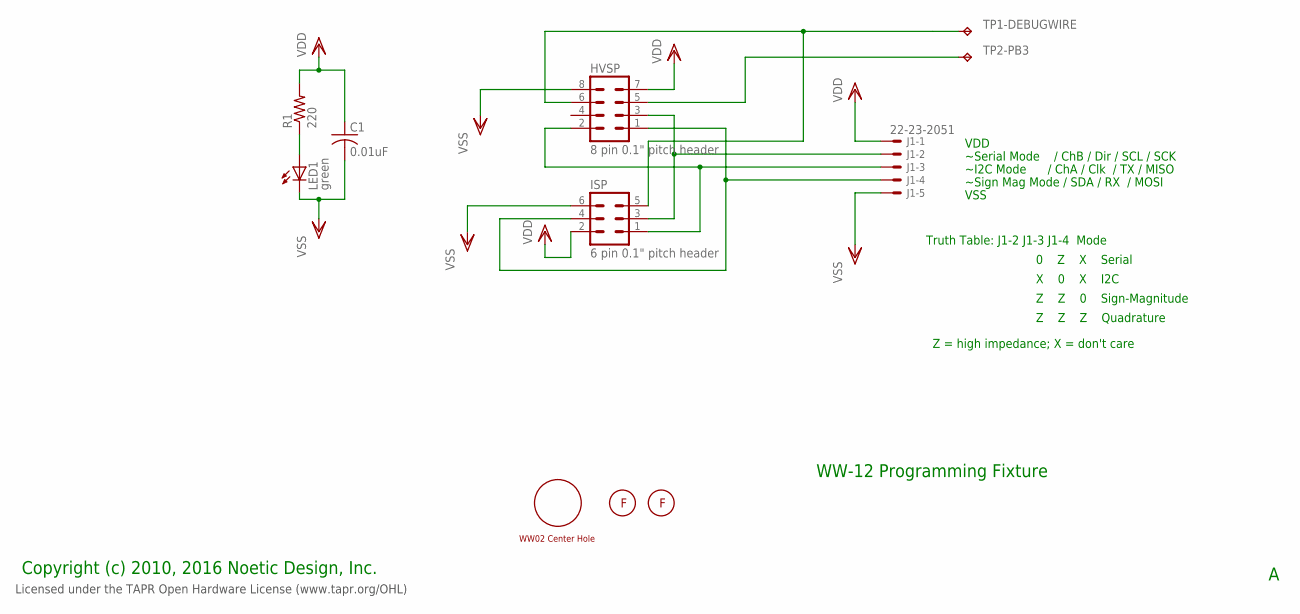
[picture p37: schematic WW-12-fixture.sch]

Parts:
C1: 0.01uF; C0603
FM1, FM2: FIDUCIAL2MMCIRCLE; FIDUCIAL_2MMCIRCLE
HVSP: 8 pin 0.1" pitch header; MA04-2
ISP: 6 pin 0.1" pitch header; MA03-2
J1: 22-23-2051
LED1: green; CHIP-LED0603
R1: 220; R0603
TP1-DEBUGWIRE, TP2-PB3: DEBUG WIRE; B1,27
U$1: WW02-CENTER

Connections:
unnamed: LED1.A, R1.1
PB0: HVSP.1, ISP.4, J1.4
PB1: HVSP.2, ISP.1, J1.3
PB2: HVSP.3, ISP.3, J1.2
TP1: HVSP.6, ISP.5, TP1-DEBUGWIRE.TP
TP2: HVSP.5, TP2-PB3.TP
VDD: C1.1, HVSP.7, ISP.2, J1.1, R1.2
VSS: C1.2, HVSP.8, ISP.6, J1.5, LED1.C

Notes on the sheet:
~Serial Mode / ChB / Dir / SCL / SCK
~I2C Mode / ChA / Clk / TX / MISO
~Sign Mag Mode / SDA / RX / MOSI
VDD
VSS
Truth Table: J1-2 J1-3 J1-4 Mode
0 Z X Serial
X 0 X I2C
Z Z 0 Sign-Magnitude
Z Z Z Quadrature
WW-12 Programming Fixture
Copyright (c) 2010, 2016 Noetic Design, Inc.
Z = high impedance; X = don't care
Licensed under the TAPR Open Hardware License (www.tapr.org/OHL)

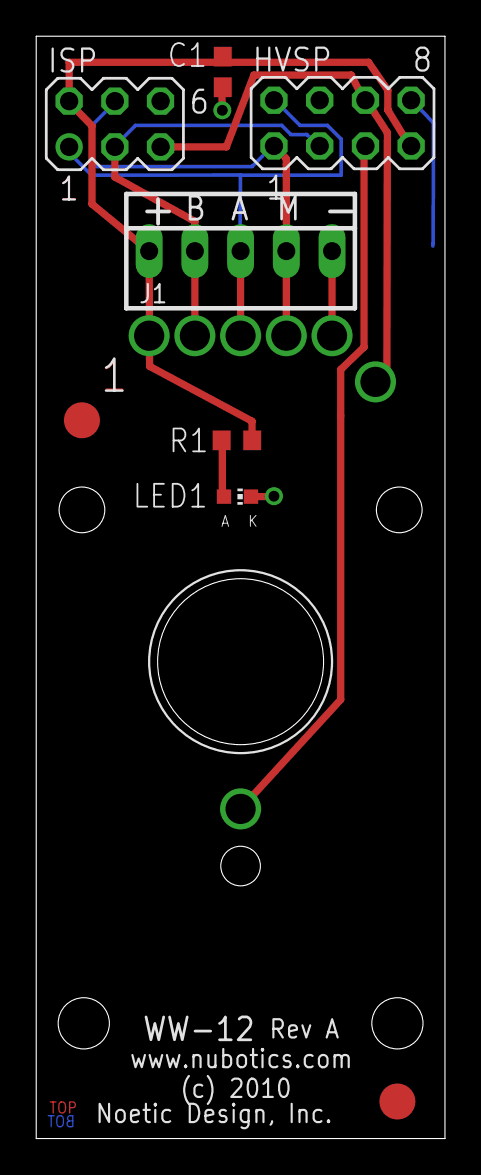
[picture p38: board WW-12-fixture.brd from above]

Board: 2 copper layers, 22.7 x 61.2 mm, 11 parts (0 on the bottom side), 8 nets.
