plskeggs/nubotics-wheelwatcher/code/WW-1x-firmware/USI_UART/USI_UART.c

/*****************************************************************************
*
* Copyright (C) 2003 Atmel Corporation
*
* File              : USI_UART.c
* Compiler          : IAR EWAAVR 2.28a
* Created           : 18.07.2002 by JLL
* Modified          : 02-10-2003 by LTA
*
* Support mail      : avr@atmel.com
*
* Supported devices : ATtiny26
*
* Application Note  : AVR307 - Half duplex UART using the USI Interface
*
* Description       : Functions for USI_UART_receiver and USI_UART_transmitter.
*                     Uses Pin Change Interrupt to detect incomming signals.
*
*
****************************************************************************/

//#include <ioavr.h>  // Note there is a bug in ioavr.h file that includes iotiny22.h instead of iotiny26.h.
//#include <iotiny26.h>
//#include <inavr.h>
#include <avr/io.h>
#include <avr/interrupt.h>
//#include <avr/boot.h>
#include <stdio.h>
#include "USI_UART_config.h"
#include "../ww_com.h"
#include "../ww_cmd.h"

//#define FULL_COMMAND_HANDLER 1

//********** USI UART Defines **********//

#define DATA_BITS                 8
#define START_BIT                 1
#define STOP_BIT                  1
#define HALF_FRAME                5

#if TIMER_PRESCALER == 1
#define PRESCALE_BITS ((0<<CS02)|(0<<CS01)|(1<<CS00))                   // Start Timer0.
#elif TIMER_PRESCALER == 8
#define PRESCALE_BITS ((0<<CS02)|(1<<CS01)|(0<<CS00))
#endif

#define USI_COUNTER_MAX_COUNT     16
#define USI_COUNTER_SEED_TRANSMIT (USI_COUNTER_MAX_COUNT - HALF_FRAME)
#define INTERRUPT_STARTUP_DELAY   (0x44 / TIMER_PRESCALER)

#define TIMER0_SEED               (256 - ( (SYSTEM_CLOCK / BAUDRATE) / TIMER_PRESCALER ))
#if ( (( (SYSTEM_CLOCK / BAUDRATE) / TIMER_PRESCALER ) * 3/2) > (256 - INTERRUPT_STARTUP_DELAY) )
    #define INITIAL_TIMER0_SEED       ( 256 - (( (SYSTEM_CLOCK / BAUDRATE) / TIMER_PRESCALER ) * 1/2) )
    #define USI_COUNTER_SEED_RECEIVE  ( USI_COUNTER_MAX_COUNT - (START_BIT + DATA_BITS) )
#else
    #define INITIAL_TIMER0_SEED       ( 256 - (( (SYSTEM_CLOCK / BAUDRATE) / TIMER_PRESCALER ) * 3/2) )
    #define USI_COUNTER_SEED_RECEIVE  (USI_COUNTER_MAX_COUNT - DATA_BITS)
#endif


#define UART_RX_BUFFER_MASK ( UART_RX_BUFFER_SIZE - 1 )
#if ( UART_RX_BUFFER_SIZE & UART_RX_BUFFER_MASK )
    #error RX buffer size is not a power of 2
#endif

#define UART_TX_BUFFER_MASK ( UART_TX_BUFFER_SIZE - 1 )
#if ( UART_TX_BUFFER_SIZE & UART_TX_BUFFER_MASK )
    #error TX buffer size is not a power of 2
#endif

/* General defines */
#define TRUE                      1
#define FALSE                     0

//********** Static Variables **********//

//__no_init __regvar static unsigned char USI_UART_TxData @ 15;   // Tells the compiler to store the byte to be transmitted in registry.
register unsigned char USI_UART_TxData asm ("r15");

static unsigned char          UART_RxBuf[UART_RX_BUFFER_SIZE];  // UART buffers. Size is definable in the header file.
static volatile unsigned char UART_RxHead;
static volatile unsigned char UART_RxTail;
static unsigned char          UART_TxBuf[UART_TX_BUFFER_SIZE];
static volatile unsigned char UART_TxHead;
static volatile unsigned char UART_TxTail;

static volatile union USI_UART_status                           // Status byte holding flags.
{
    unsigned char status;
    struct
    {
        unsigned char ongoing_Transmission_From_Buffer:1;
        unsigned char ongoing_Transmission_Of_Package:1;
        unsigned char ongoing_Reception_Of_Package:1;
        unsigned char reception_Buffer_Overflow:1;
        unsigned char flag4:1;
        unsigned char flag5:1;
        unsigned char flag6:1;
        unsigned char flag7:1;
    };
} USI_UART_status = {0};


//********** USI_UART functions **********//

// Reverses the order of bits in a byte.
// I.e. MSB is swapped with LSB, etc.
unsigned char 
BOOTLOADER_SECTION 
Bit_Reverse( unsigned char x )
{
    x = ((x >> 1) & 0x55) | ((x << 1) & 0xaa);
    x = ((x >> 2) & 0x33) | ((x << 2) & 0xcc);
    x = ((x >> 4) & 0x0f) | ((x << 4) & 0xf0);
    return x;    
}

// Flush the UART buffers.
void 
BOOTLOADER_SECTION 
USI_UART_Flush_Buffers( void )  
{  
    UART_RxTail = 0;
    UART_RxHead = 0;
    UART_TxTail = 0;
    UART_TxHead = 0;
}

// Initialise USI for UART transmission.
void 
BOOTLOADER_SECTION 
USI_UART_Initialise_Transmitter( void )                              
{
    //__disable_interrupt();
    cli();
    TCNT0  = 0x00;
    GTCCR  = (1<<PSR0);                                       // Reset the prescaler.
    OCR0A = 0xFF;
    OCR0B = 0xFF;
    TCCR0A = 0;                                               // Select normal mode.
    TCCR0B = PRESCALE_BITS;                                   // Start Timer0.
    TIFR   = (1<<TOV0);                                       // Clear Timer0 OVF interrupt flag.
    TIMSK |= (1<<TOIE0);                                      // Enable Timer0 OVF interrupt.

    USICR  = (0<<USISIE)|(1<<USIOIE)|                         // Enable USI Counter OVF interrupt.
             (0<<USIWM1)|(1<<USIWM0)|                         // Select Three Wire mode.
             (0<<USICS1)|(1<<USICS0)|(0<<USICLK)|             // Select Timer0 OVER as USI Clock source.
             (0<<USITC);                                           

    USIDR  = 0xFF;                                            // Make sure MSB is '1' before enabling USI_DO.
    USISR  = 0xF0 |                                           // Clear all USI interrupt flags.
             0x0F;                                            // Preload the USI counter to generate interrupt at first USI clock.
    DDRB  |= (1<<PB1);                                        // Configure USI_DO as output.

    USI_UART_status.ongoing_Transmission_From_Buffer = TRUE;

    //__enable_interrupt();
    sei();
}

// Initialise USI for UART reception.
// Note that this function only enables pinchange interrupt on the USI Data Input pin.
// The USI is configured to read data within the pinchange interrupt.
void 
BOOTLOADER_SECTION 
USI_UART_Initialise_Receiver( void )        
{  
    PORTB |=   (1<<PB3)|(1<<PB2)|(1<<PB1)|(1<<PB0);         // Enable pull up on USI DO, DI and SCK pins. (And PB3 because of pin change interrupt)
    DDRB  &= ~((1<<PB3)|(1<<PB2)|(1<<PB1)|(1<<PB0));        // Set USI DI, DO and SCK pins as inputs.  
    TCCR0B = 0;                                             // stop timer0
    OCR0A = 0xFF;
    OCR0B = 0xFF;
    USICR  =  0;                                            // Disable USI.
    GIFR   =  (1<<PCIF);                                    // Clear pin change interrupt flag.
    PCMSK |=  (1<<PB0);                                     // Enable only PB0 (RX/DI)
    GIMSK |=  (1<<PCIE);                                    // Enable pin change interrupt for PB0.
}

int 
BOOTLOADER_SECTION 
USI_UART_PutChar(char c, FILE *f)
{
    USI_UART_Transmit_Byte(c);
    return(int)c;
}

// Puts data in the transmission buffer, after reverseing the bits in the byte.
// Initiates the transmission rutines if not already started.
void 
BOOTLOADER_SECTION 
USI_UART_Transmit_Byte( unsigned char data )          
{
    unsigned char tmphead;

    tmphead = ( UART_TxHead + 1 ) & UART_TX_BUFFER_MASK;        // Calculate buffer index.
    while ( tmphead == UART_TxTail );                           // Wait for free space in buffer.
    UART_TxBuf[tmphead] = Bit_Reverse(data);                    // Reverse the order of the bits in the data byte and store data in buffer.
    UART_TxHead = tmphead;                                      // Store new index.

    if (!USI_UART_status.ongoing_Transmission_From_Buffer)      // Start transmission from buffer (if not already started).
    {
        while (USI_UART_status.ongoing_Reception_Of_Package);   // Wait for USI to finsh reading incoming data.
        USI_UART_Initialise_Transmitter();              
    }
}

int 
BOOTLOADER_SECTION 
USI_UART_GetChar(FILE *f)
{
    return(int)USI_UART_Receive_Byte();
}

// Returns a byte from the receive buffer. Waits if buffer is empty.
unsigned char 
BOOTLOADER_SECTION 
USI_UART_Receive_Byte(void)
{
    unsigned char tmptail;

    while (UART_RxHead == UART_RxTail);                   // Wait for incomming data 
    tmptail = (UART_RxTail + 1) & UART_RX_BUFFER_MASK;    // Calculate buffer index 
    UART_RxTail = tmptail;                                // Store new index 
    return Bit_Reverse(UART_RxBuf[tmptail]);              // Reverse the order of the bits in the data byte before it returns data from the buffer.
}

// Check if there is data in the receive buffer.
unsigned char 
BOOTLOADER_SECTION 
USI_UART_Data_In_Receive_Buffer(void)
{
    return(UART_RxHead != UART_RxTail);                  // Return 0 (FALSE) if the receive buffer is empty.
}


// ********** Interrupt Handlers ********** //

// The pin change interrupt is used to detect USI_UART reseption.
// It is here the USI is configured to sample the UART signal.
//#pragma vector=IO_PINS_vect                                       
//__interrupt void IO_Pin_Change_ISR(void)                                
#ifdef CHINT
BOOTLOADER_SECTION 
SIGNAL(SIG_PIN_CHANGE)
{
    if (!(PINB & (1<<PB0)))                                       // If the USI DI pin is low, then it is likely that it
    {
        //  was this pin that generated the pin change interrupt.
#else
void 
BOOTLOADER_SECTION 
USI_UART_change_handler(void)
{
    {
#endif
        TCNT0  = INTERRUPT_STARTUP_DELAY + INITIAL_TIMER0_SEED;   // Plant TIMER0 seed to match baudrate (incl interrupt start up time.).
        GTCCR  = (1<<PSR0);                                       // Reset the prescaler.
        TCCR0B = PRESCALE_BITS;                                   // Start Timer0.
        TIFR   = (1<<TOV0);                                       // Clear Timer0 OVF interrupt flag.
        TIMSK |= (1<<TOIE0);                                      // Enable Timer0 OVF interrupt.

        USICR  = (0<<USISIE)|(1<<USIOIE)|                         // Enable USI Counter OVF interrupt.
                 (0<<USIWM1)|(1<<USIWM0)|                         // Select Three Wire mode.
                 (0<<USICS1)|(1<<USICS0)|(0<<USICLK)|             // Select Timer0 OVER as USI Clock source.
                 (0<<USITC);                                           
        // Note that enabling the USI will also disable the pin change interrupt.
        USISR  = 0xF0 |                                           // Clear all USI interrupt flags.
                 USI_COUNTER_SEED_RECEIVE;                        // Preload the USI counter to generate interrupt.
        GIMSK &=  ~(1<<PCIE);                                    // Disable pin change interrupt for PB3:0. 
        USI_UART_status.ongoing_Reception_Of_Package = TRUE;
    }
}

// The USI Counter Overflow interrupt is used for moving data between memmory and the USI data register.
// The interrupt is used for both transmission and reception.
//#pragma vector=USI_OVF_vect                                             
//__interrupt void USI_Counter_Overflow_ISR(void)                              
//SIGNAL(SIG_USI_OVERFLOW)
void 
BOOTLOADER_SECTION 
USI_UART_OVERFLOW_ISR(void)
{
    unsigned char tmphead,tmptail;

    // Check if we are running in Transmit mode.
    if (USI_UART_status.ongoing_Transmission_From_Buffer)
    {
        // If ongoing transmission, then send second half of transmit data.
        if (USI_UART_status.ongoing_Transmission_Of_Package)
        {
            USI_UART_status.ongoing_Transmission_Of_Package = FALSE;    // Clear on-going package transmission flag.

            USISR = 0xF0 | (USI_COUNTER_SEED_TRANSMIT);                 // Load USI Counter seed and clear all USI flags.
            USIDR = (USI_UART_TxData << 3) | 0x07;                      // Reload the USIDR with the rest of the data and a stop-bit.
            GIMSK |=  (1<<PCIE);                                    // Enable pin change interrupt for PB3:0.
        }
        // Else start sendinbg more data or leave transmit mode.
        else
        {
            // If there is data in the transmit buffer, then send first half of data.
            if (UART_TxHead != UART_TxTail)
            {
                USI_UART_status.ongoing_Transmission_Of_Package = TRUE; // Set on-going package transmission flag.

                tmptail = (UART_TxTail + 1) & UART_TX_BUFFER_MASK;      // Calculate buffer index.
                UART_TxTail = tmptail;                                  // Store new index.            
                USI_UART_TxData = UART_TxBuf[tmptail];                  // Read out the data that is to be sent. Note that the data must be bit reversed before sent.
                                                                        // The bit reversing is moved to the application section to save time within the interrupt.
                USISR  = 0xF0 | (USI_COUNTER_SEED_TRANSMIT);            // Load USI Counter seed and clear all USI flags.
                USIDR  = (USI_UART_TxData >> 2) | 0x80;                 // Copy (initial high state,) start-bit and 6 LSB of original data (6 MSB
                                                                        //  of bit of bit reversed data).                
                GIMSK &=  ~(1<<PCIE);                                   // Disable pin change interrupt for PB3:0. 
            }
            // Else enter receive mode.
            else
            {
                USI_UART_status.ongoing_Transmission_From_Buffer = FALSE; 

                DDRB  &= ~(1<<PB1);                                     // Configure USI_DO as input.
                TCCR0B = (0<<CS02)|(0<<CS01)|(0<<CS00);                 // Stop Timer0.
//              PORTB |=   (1<<PB3)|(1<<PB2)|(1<<PB1)|(1<<PB0);         // Enable pull up on USI DO, DI and SCK pins. (And PB3 because of pin change interrupt)   
//              DDRB  &= ~((1<<PB3)|(1<<PB2)|(1<<PB1)|(1<<PB0));        // Set USI DI, DO and SCK pins as inputs.  
                USICR  =  0;                                            // Disable USI.
//              GIFR   =  (1<<PCIF);                                    // DON'T OR WE COULD MISS INTERRUPTS: Clear pin change interrupt flag.
                PCMSK |=  (1<<PB0);                                     // Enable only PB0 (RX/DI)
                GIMSK |=  (1<<PCIE);                                    // Enable pin change interrupt for PB3:0.
            }
        }
    }

    // Else running in receive mode.
    else
    {
        USI_UART_status.ongoing_Reception_Of_Package = FALSE;           

        tmphead = (UART_RxHead + 1) & UART_RX_BUFFER_MASK;      // Calculate buffer index.

        if (tmphead == UART_RxTail)                             // If buffer is full trash data and set buffer full flag.
        {
            USI_UART_status.reception_Buffer_Overflow = TRUE;   // Store status to take actions elsewhere in the application code
        } 
        else                                                    // If there is space in the buffer then store the data.
        {
            UART_RxHead = tmphead;                              // Store new index.
            UART_RxBuf[tmphead] = USIBR;                        // Store received data in buffer. Note that the data must be bit reversed before used. 
#ifdef FULL_COMMAND_HANDLER
            ctrl.flags.process_cmd = handle_serial_received_byte(ctrl.flags.process_cmd);
#endif
        }                                                       // The bit reversing is moved to the application section to save time within the interrupt.

        TCCR0B = (0<<CS02)|(0<<CS01)|(0<<CS00);                 // Stop Timer0.
//      PORTB |=   (1<<PB3)|(1<<PB2)|(1<<PB1)|(1<<PB0);         // Enable pull up on USI DO, DI and SCK pins. (And PB3 because of pin change interrupt)   
//      DDRB  &= ~((1<<PB3)|(1<<PB2)|(1<<PB1)|(1<<PB0));        // Set USI DI, DO and SCK pins as inputs.  
        USICR  =  0;                                            // Disable USI.
//      GIFR   =  (1<<PCIF);                                    // Clear pin change interrupt flag.
        PCMSK |=  (1<<PB0);                                     // Enable only PB0 (RX/DI)
        GIMSK |=  (1<<PCIE);                                    // Enable pin change interrupt for PB3:0.
    }
}

// Timer0 Overflow interrupt is used to trigger the sampling of signals on the USI ports.
//#pragma vector=TIMER0_OVF0_vect             
//__interrupt void Timer0_OVF_ISR(void)
BOOTLOADER_SECTION 
SIGNAL(SIG_OVERFLOW0)
{
    TCNT0 += TIMER0_SEED;                   // Reload the timer,
                                            // current count is added for timing correction.
}
